Noodle-Box/Macrolyze---Team-Project-II/README.md

# Macrolyze---Team-Project-II
Bluetooth Keyboard for ENGG3800 - Team Project II

Hardware Files included:

1. PDF Schematic Document
2. Altium Schematic Document
3. BOM (Brief of Materials)
