Noodle-Box/Macrolyze---Team-Project-II/TEAM12_BOM_ENGG3800.xlsx

Designator | Description | Quantity | Price each | Total price | Manufacturer | Manufacturer # | Supplier | Supplier # | RoHS link
BATT1 | Polymer Lithium Ion Battery (LiPo) 3.7V 1000mAh | 1 | $12.84 | $12.84 | N/A | N/A | ETSG | 28-11-05 | Not Required
BT1 | CONNECTOR : JST PH - Top Entry Header / Surface Mount / 02 Way / 2.00mm Pitch | 1 | $1.56 | $1.56 | JST Crimp | S2B-PH-K-S | ETSG | 08-54-01 | See Supplier
C1,2,3,4,5,7,9,10,11,12,13,14,15,16,17,18,19,21,23 | CAPACITOR : Ceramic / 0805 /surface mount / 100000 / 100n / 50V / X7R / ±10% | 19 | $0.01 | $0.19 | Multicomp | MCU0805R104KCT | ETSG | 64-04-12 | See Supplier
C20,22,24 | CAPACITOR : Ceramic / 0805 /surface mount / 10000000 / 10u / 10V / X5R / 10% | 2 | $0.02 | $0.04 | Multicomp | MCU0805R106KCT | ETSG | 64-05-12 | See Supplier
C25 | CAPACITOR : Ceramic / 1206 / surface mount/ 1000000 / 1u / 25V / X7R / 10% | 1 | $0.13 | $0.13 | Multicomp | MCU1206R105KCT | ETSG | 64-05-08 | See Supplier
C26 | CAPACITOR : Ceramic / 1206 / surface mount/ 100u / 6.3V / X5R / 20% | 1 | $0.55 | $0.55 | muRata | GRM31CR60J107MEA8# | Digikey | 490-GRM31CR60J107MEA8KCT-ND | https://www.digikey.com.au/en/products/detail/murata-electronics/GRM31CR60J107MEA8K/13904877
C6,8 | CAPACITOR : Ceramic / 0805 /surface mount / 22 / 22p / 50V / COG | 2 | $0.08 | $0.16 | Multicomp | MCU0805C220KCT | ETSG | 64-02-05 | See USB
D1, D2 | Diode 40 V 1A Through Hole DO-41 | 2 | $0.43 | $0.86 | STMicroelectronics | 1N5819 | Digikey | 497-6610-1-ND | https://www.digikey.com.au/en/products/detail/stmicroelectronics/1N5819/1037326
D3 | LED, Red, SMD, 1.25mm × 1.4mm, 20mA, 1.85V, 643 nm | 1 | $0.38 | $0.38 | Multicomp | MCL-S270SRC | ETSG | 63-07-03 | See Supplier
D4 | LED, Blue, SMD, 1.25mm × 1.4mm, 20mA, 1.85V, 643 nm | 1 | $0.27 | $0.27 | Multicomp | OVS-08 | ETSG | 63-07-04 | See Supplier
DNP | Keycaps for Kailh Mechanical Keyboard Switches - CE08137 | 12 | $0.81 | $9.72 | Kalih Eletronics | CE08137 | ETSG | 25-13-03 | Not Required
DNP | Kailh Mechanical Key Switches - ADA4955 | 12 | $0.62 | $7.44 | Kalih Eletronics | ADA4955 | ETSG | 25-13-01 | See USB
DNP | 3M Hemispherical PUR/ Self Adhesive Feet / 11.2mm diameter x 5mm height | 4 | $0.12 | $0.48 | 3M Bumpon | SJ5003 | ETSG | 16-59-03 | -
DNP | CONNECTOR : JST PH - Crimp Terminal Housing / 02 Way / 2.00mm Pitch | 1 | $0.07 | $0.07 | JST Crimp | S2B-PH-K-S | ETSG | 08-49-01 | See Supplier
DNP | CONNECTOR : JST PH - Crimp Terminal / Use Crimp Tool K143 | 2 | $0.02 | $0.04 | JST Crimp | BPH-002T-P0.5S | ETSG | 08-50-03 | See Supplier
F1 | FUSES : Axial Lead / Quick Blow (F) / Ceramic / Standard / 01.000A / 1A / 125VAC | 1 | $1.75 | $1.75 | Littelfuse Inc. | 0251001.MRT1L | Digikey | F3169CT-ND | https://www.digikey.com.au/en/products/detail/littelfuse-inc/0251001-MRT1L/700720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
HW1,2 | FASTENER : Spacer / Female - Female / Nylon / Hexagonal / M3 x 12 | 2 | $0.22 | $0.44 | RS Pro | 325-643 | ETSG | 10-41-03 | See USB
HW3,4,5 | CONNECTOR : PCB HDR - Single Row Header / Female / Straight / 1 x 08 / Gold Plated | 3 | $0.35 | $1.04 | Multicomp | 2212S-08SG-85 | Element14 | 1593463 | https://au.element14.com/multicomp/2212s-08sg-85/socket-pcb-1-row-8way/dp/1593463?ost=1593463
P1 | J Link HEADER : Connector SMD 10 Pins 1.27mm Box Header Surface Mount | 1 | $0.80 | $0.80 | CnC Tech | 3220-XX-0300-00 | ETSG | 07-31-01 | See USB
P17 | YELLOW Test Point CONNECTOR : PCB Test Point / Raised Loop / Red / 1.06 mm | 1 | $0.39 | $0.39 | Keystone | 50145023 | ETSG | 01-95-02 | See USB
P3,12 | Jumper, 2 Pin Connection | 2 | $0.09 | $0.18 | Assmann WSW Components | AKSPT/x-x | ETSG | 01-96-02 | See Supplier
P4, P5 | RED Test Point CONNECTOR : PCB Test Point / Raised Loop / Red / 1.06 mm | 2 | $0.38 | $0.76 | Keystone | 50105023 | ETSG | 01-95-01 | See USB
P6, P16 | BLACK Test Point CONNECTOR : PCB Test Point / Raised Loop / Black / 1.06 mm | 2 | $0.39 | $0.78 | Keystone | 50115023 | ETSG | 01-96-01 | See USB
PCB | PCB External / Team Project / Thesis / Unit cost | 1 | $18.23 | $18.23 | Pinecone (Hengyi Design) |  | ETSG | https://pinecone2.uqcloud.net/pcb/65210836e9f09b73cca3b043 | See Supplier
Q1 | MOSFET P-CH 100V 23A TO220AB | 1 | $2.50 | $2.50 | Infineon Technologies | IRF9540NPBF | Digikey | IRF9540NPBF-ND | https://www.digikey.com.au/en/products/detail/infineon-technologies/IRF9540NPBF/812088
Q2 | SENSOR PHOTO 860NM TOP VIEW RAD | 1 | $0.94 | $0.94 | ams-OSRAM USA INC. | SFH 309-4/5 | Digikey | 475-SFH309-4/5-ND | https://www.digikey.com.au/en/products/detail/ams-osram-usa-inc/SFH-309-4-5/2205891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
R3 | RES SMD 1M OHM 1% 1/4W 1206 | 1 | $0.16 | $0.16 | TE Connectivity Passive Product | CRG1206F1M0 | Digikey | A106072CT-ND | https://www.digikey.com.au/en/products/detail/te-connectivity-passive-product/CRG1206F1M0/2380979
R4,5,7,11 | RES SMD 1K OHM 1% 1/8W 0805 | 4 | $0.16 | $0.64 | TE Connectivity Passive Product | CRG0805F1K0 | Digikey | A106056CT-ND | https://www.digikey.com.au/en/products/detail/te-connectivity-passive-product/CRG0805F1K0/2380857
R6 | RES 2.4K OHM 1% 1/8W 0805 | 1 | $0.16 | $0.16 | YAGEO | RC0805FR-072K4L | Digikey | 311-2.40KCRCT-ND | https://www.digikey.com.au/en/products/detail/yageo/RC0805FR-072K4L/727690
R8,9,10 | RES 10K OHM 1% 1/8W 0805 | 3 | $0.16 | $0.48 | TE Connectivity Passive Product | CRGCQ0805F10K | Digikey | A129761CT-ND | https://www.digikey.com.au/en/products/detail/te-connectivity-passive-product/CRGCQ0805F10K/8576363
S13 | Reset Pushbutton: Surface Mount / Push / 6mm x 6mm / SPST = no | 1 | $0.36 | $0.36 | Schurter | 1301.9318.24 | Digikey | 486-4878-1-ND | https://www.digikey.com.au/en/products/detail/schurter-inc/1301-9318-24/9094764
SW1 | SWITCH : PCB Mount / Slide / Min / SPDT = (on) < w > (off) | 1 | $2.59 | $2.59 | Secme | 09.030201.02 | ETSG | 10-09-03 | See Supplier
SW14 to SW25 | Kailh Switch Sockets for MX-compatible Mechanical Keys - ADA4958 | 12 | $0.34 | $4.08 | Kailh Eeletronics | CPG151101S11-16 | ETSG | 25-13-02 | See USB
U to U12 | 3.2x2.8x1.78 mm 0.2W Intelligent external control surface mount SMD LED | 12 | $0.22 | $2.64 | DONGGUAN OPSCO OPTOELECTRONICS CO., LTD | SK6812MINI-E | ETSG | 25-13-05 | See USB
U1 | Microcontroller - STM32L433CCU6 | 1 | $7.48 | $7.48 | STMicroelectronics | STM32L433CCT6 | ETSG | 66-01-03 | https://www.digikey.com.au/en/products/detail/stmicroelectronics/STM32L433CCT6/6132750
U13 | Seeeduino XIAO - Arduino Microcontroller - SAMD21 Cortex M0+ | 1 | $8.25 | $8.25 | Atmel | 102010328 | ETSG | 24-01-01 | See Supplier
U14 | LCD Display / 0.96" SPI 160 x 80 TFT / VDD 3.3V | 1 | $4.00 | $4.00 | EastRising Technology Co., Limited | ER-TFTM0.96A1-1 | ETSG | 24-05-07 | See USB
U15 | Wifi / Bluetooth Module / ESP32-C3-WROOM-02-H4 / Multiprotocol Modules SMD module, ESP32-C3, 4MB SPI flash, PCB antenna, -40 C +105 C | 1 | $3.08 | $3.08 | Espressif Systems | ESP32-C3-WROOM-02-N4 | ETSG | 26-04-01 | https://www.digikey.com.au/en/products/detail/espressif-systems/ESP32-C3-WROOM-02-N4/14553031
U16 | IC REG LINEAR 3.3V 250MA TO92-3 | 1 | $0.71 | $0.71 | Microchip Technology | MCP1700-3302E/TO | Digikey | MCP1700-3302E/TO-ND | https://www.digikey.com.au/en/products/detail/microchip-technology/MCP1700-3302E-TO/652680
U17 | IC BATT CHG Li-Pol 5V input,4V2 out, 1A | 1 | $2.70 | $2.70 | Microchip Technology | MCP73843-420I/MS | Element14 | 1852163 | https://au.element14.com/microchip/mcp73843-420i-ms/batt-charger-li-ion-4-2v-8msop/dp/1852163
Y | TIMING FUNCTIONS : Crystal / 8MHz / HC49/4HSMX Packag | 1 | $0.10 | $0.10 | RALTRON | AS-8.000-30-3030-SMD-TR | Element14 | 4166003 | https://au.element14.com/raltron/as-8-000-30-3030-smd-tr/crystal-8mhz-30pf-smd-12mm-x-4/dp/4166003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
 |  | PROJECT TOTAL: |  | $99.97
