Noodle-Box/Macrolyze---Team-Project-II/Macrolyze - Final Schematic.pdf

ENGG3800 Team 12 - Macrolyze | Hardware: Tevyn Vergara Software: Dingyi Zhang

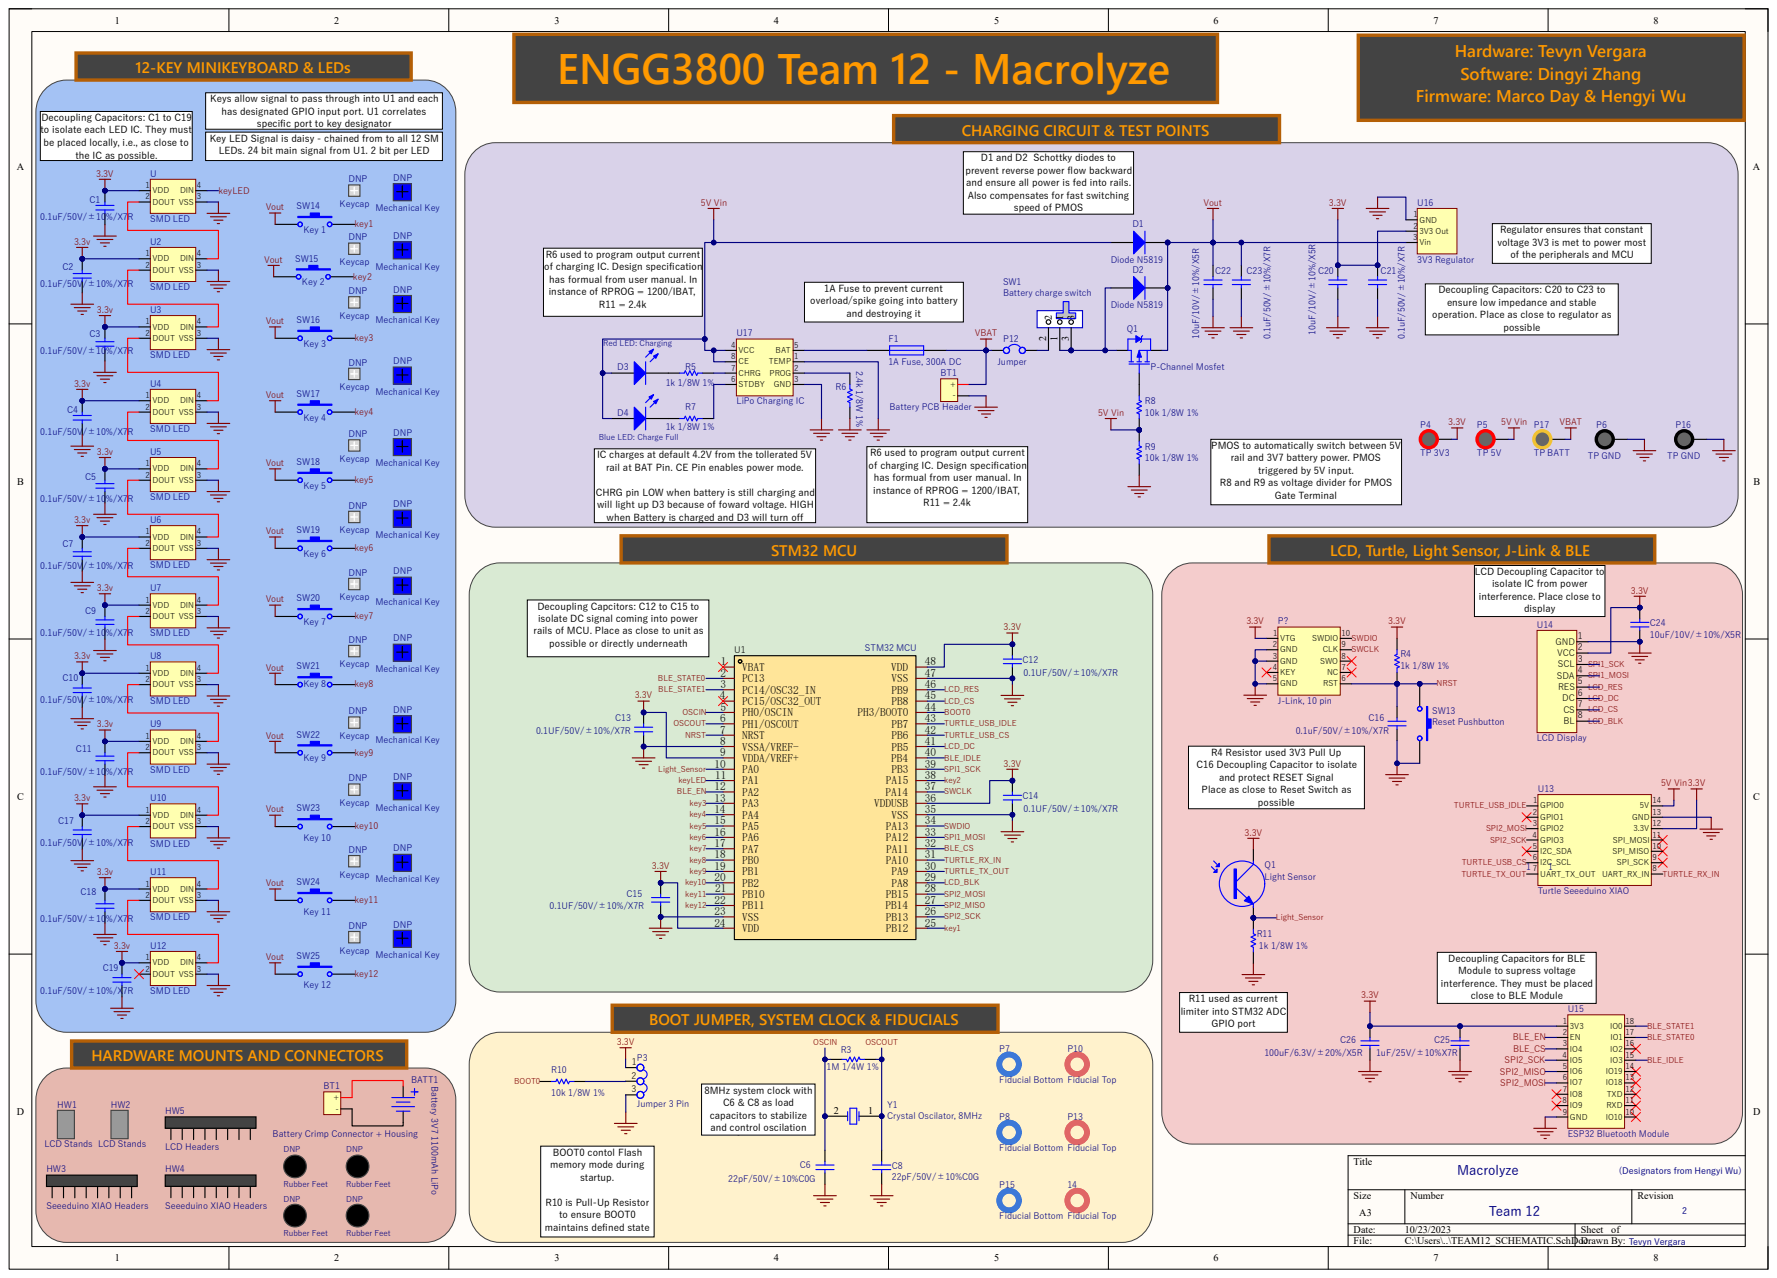
[picture p1: page 1]

Keys allow signal to pass through into U1 and each
has designated GPIO input port. U1 correlates
specific port to key designator

Firmware: Marco Day & Hengyi Wu

Decoupling Capacitors: C1 to C19
to isolate each LED IC. They must
be placed locally, i.e., as close to
the IC as possible.

CHARGING CIRCUIT & TEST POINTS

Key LED Signal is daisy - chained from to all 12 SM
LEDs. 24 bit main signal from U1. 2 bit per LED

D1 and D2 Schottky diodes to
prevent reverse power flow backward
and ensure all power is fed into rails.
Also compensates for fast switching

Regulator ensures that constant
voltage 3V3 is met to power most
of the peripherals and MCU

R6 used to program output current
of charging IC. Design specification
has formual from user manual. In
instance of RPROG = 1200/IBAT,

1A Fuse to prevent current
overload/spike going into battery
and destroying it

Decoupling Capacitors: C20 to C23 to
ensure low impedance and stable
operation. Place as close to regulator as

Blue LED: Charge Full
IC charges at default 4.2V from the tollerated 5V
rail at BAT Pin. CE Pin enables power mode.

PMOS to automatically switch between 5V
rail and 3V7 battery power. PMOS
triggered by 5V input.

CHRG pin LOW when battery is still charging and
will light up D3 because of foward voltage. HIGH
when Battery is charged and D3 will turn off

R8 and R9 as voltage divider for PMOS

LCD Decoupling Capacitor to
isolate IC from power
interference. Place close to

Decoupling Capcitors: C12 to C15 to
isolate DC signal coming into power
rails of MCU. Place as close to unit as
possible or directly underneath

R4 Resistor used 3V3 Pull Up
C16 Decoupling Capacitor to isolate
and protect RESET Signal
Place as close to Reset Switch as

Decoupling Capacitors for BLE
Module to supress voltage
interference. They must be placed
close to BLE Module

BOOT JUMPER, SYSTEM CLOCK & FIDUCIALS

HARDWARE MOUNTS AND CONNECTORS

Battery Crimp Connector + Housing
DNP

(Designators from Hengyi Wu)

R10 is Pull-Up Resistor
to ensure BOOT0
maintains defined state
