Noodle-Box/Macrolyze---Team-Project-II/(list of files, drawings)

Other design files:
TEAM12_SCHEMATIC.SchDoc
